danielcarton/Masters/README.md

Codebase for use in master's project spring 2024 by Daniel Carton and Tobias Lien.
