danielcarton/Masters/Energy_harvester_iot/Diagrams/Generated_temperature_trace.png

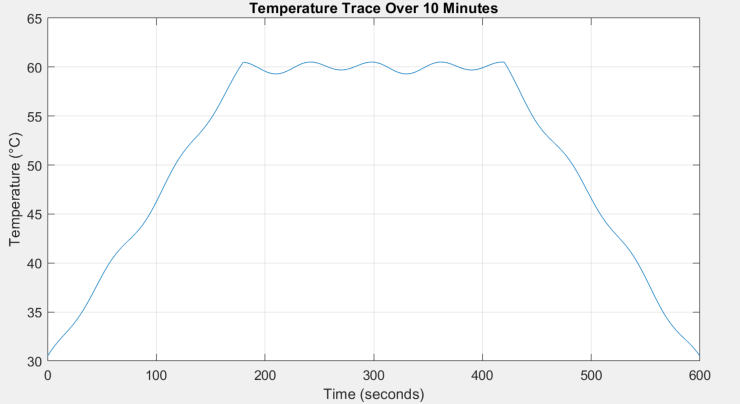
Energy_harvester_iot/Diagrams/Generated_temperature_trace.png
