danielcarton/Masters/Energy_harvester_iot/Diagrams/PID_temperature.png

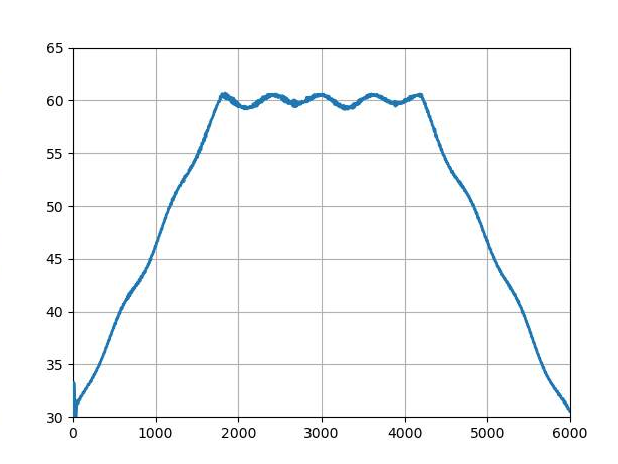
Energy_harvester_iot/Diagrams/PID_temperature.png
