danielcarton/Masters/Energy_harvester_iot/Diagrams/systemArchitecture - SoC.png

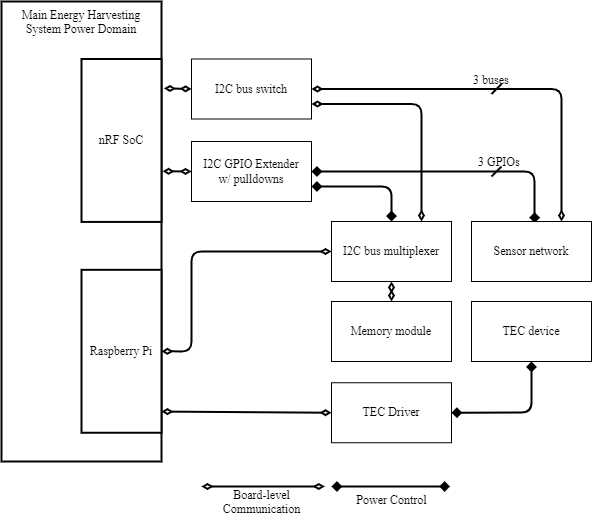
Energy_harvester_iot/Diagrams/systemArchitecture - SoC.png
