danielcarton/Masters/Energy_harvester_iot/Diagrams/EH-IoT_Eval_Board_Hardware_Architecture.pdf

## LED

## ADC 1

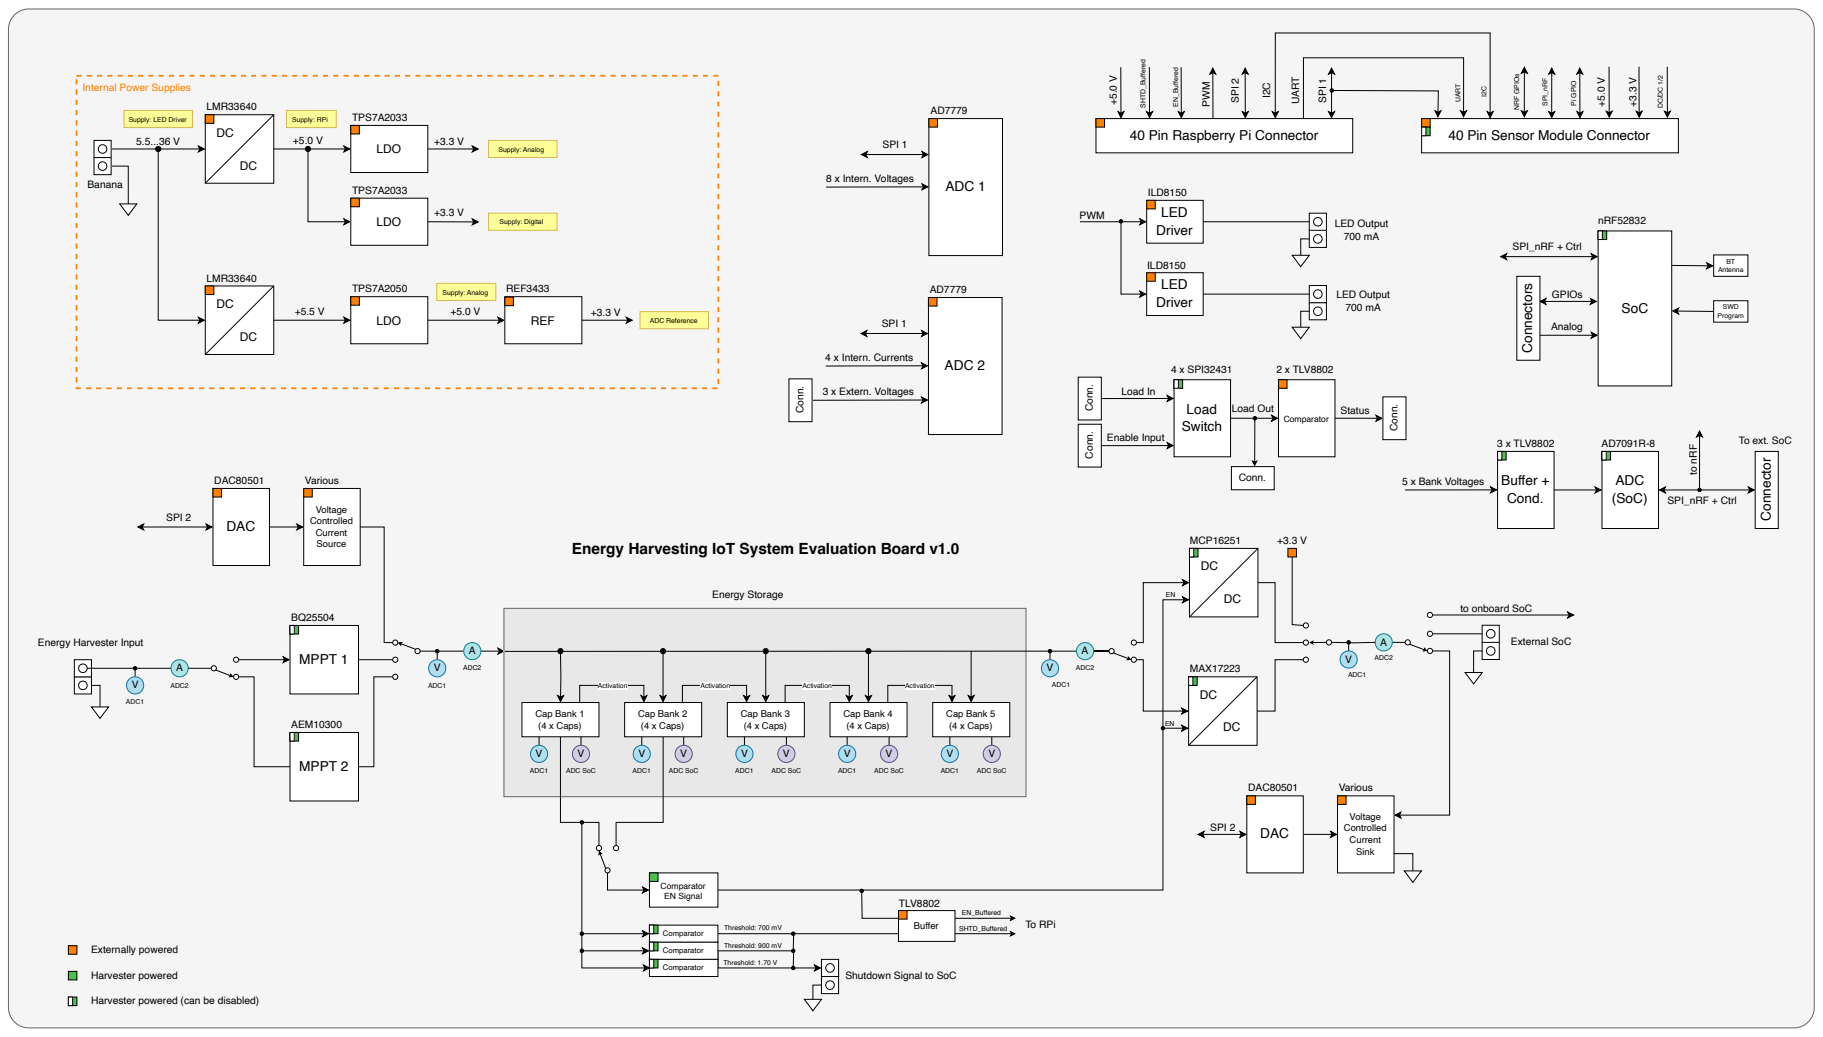
[picture p4: page 1]
LDO; TPS7A2033; LMR33640; REF; TPS7A2050; REF3433; MPPT 1; DAC; DAC80501; Voltage Controlled Current Source; Various; Activation; Cap Bank 1 (4 x Caps); Cap Bank 2 (4 x Caps); Cap Bank 3 (4 x Caps); Cap Bank 4 (4 x Caps); Cap Bank 5 (4 x Caps); ADC1; ADC2; Comparator EN Signal; Comparator; Threshold: 700 mV; Threshold: 900 mV; Threshold: 1.70 V; Voltage Controlled Current Sink; ADC (SoC); Buffer + Cond.; 3 x TLV8802; ADC SoC; 5 x Bank Voltages; Connector; Driver; PWM; SPI_nRF + Ctrl; SPI 2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

40 Pin Sensor Module Connector NRF GPIOs

Internal Power Supplies

Supply: LED Driver

40 Pin Raspberry Pi Connector

To ext. SoC

Energy Harvesting IoT System Evaluation Board v1.0

to onboard SoC

Shutdown Signal to SoC

Harvester powered (can be disabled)
