danielcarton/Masters/Energy_harvester_iot/Diagrams/Student_Project_EH-IOT_BlockDiagram.pdf

## Energy Harvesting IoT System Evaluation Board v1.0

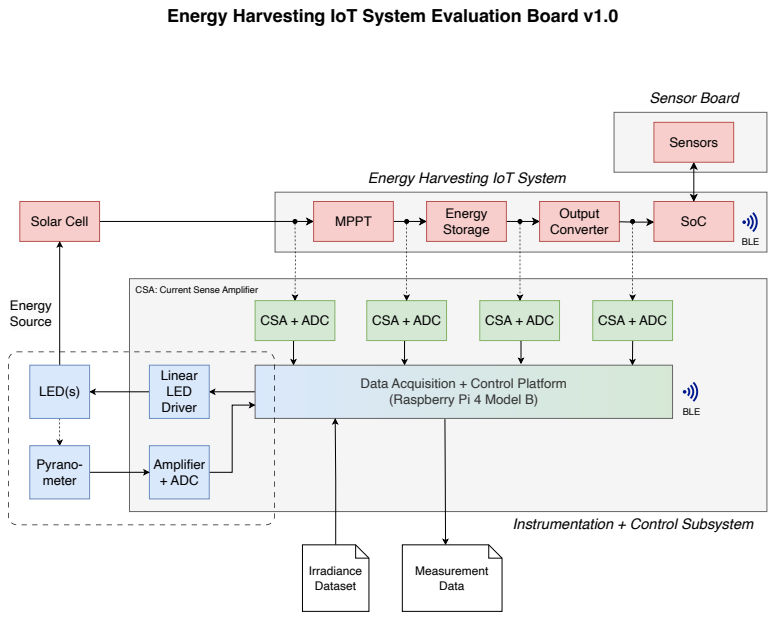
[picture p5: page 1]
Solar Cell; MPPT; Energy; Storage; Output Converter; CSA + ADC; Linear LED Driver; LED(s); Energy Source; Amplifier + ADC; Pyrano- meter; SoC; Sensors; Sensor Board; BLE; Irradiance Dataset; Measurement Data

Energy Harvesting IoT System

CSA: Current Sense Amplifier

Data Acquisition + Control Platform
(Raspberry Pi 4 Model B)

Instrumentation + Control Subsystem

## Energy Harvesting IoT System Evaluation Board v1.0

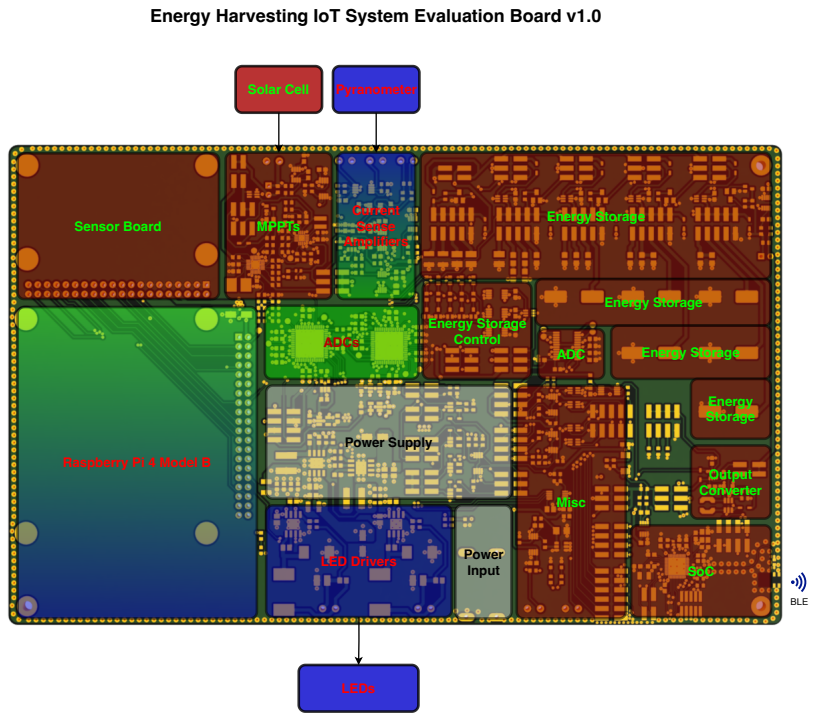
[picture p6: page 2]
MPPTs; Energy Storage; ADCs; LED Drivers; SoC; Sensor Board; Output Converter; Power Supply; Power Input; Solar Cell; LEDs; Current Sense Amplifiers; ADC; Misc; Energy Storage Control; Pyranometer; BLE

Raspberry Pi 4 Model B
