danielcarton/Masters/Energy_harvester_iot/Code/RaspberryPi/EH_IoT_Eval_240415/EH_IoT_Eval-master/modules/pinOut_BOARD.py

TP10            = 1
I2C_SDA         = 3
I2C_SCI         = 5
SHTD_BUF        = 7
UART_TXD        = 8
UART_RXD        = 10
SPI_2_CS_DAC2   = 11
SPI_2_CS_DAC1   = 12
ADC2_CONVST_SAR = 13
RPI_GPIO_22     = 15
ADC1_DRDY       = 16
ADC12_RESET     = 18
SPI_1_MOSI      = 19
SPI_1_MISO      = 21
ADC1_CONVST_SAR = 22
SPI_1_SCLK      = 23
SPI_1_CS_ADC1   = 24
SPI_1_CS_ADC2   = 26
CH1_READY       = 29
CH2_READY       = 31
LED_DRV_DIM     = 32
CH3_READY       = 33
CH4_READY       = 35
SPI_1_CS_3      = 36
DCDC_EN_BUF     = 37
SPI_2_MOSI      = 38
SPI_2_SCLK      = 40
