danielcarton/Masters/Energy_harvester_iot/Code/SoC/src/I2C_control.c

// #include "I2C_control.h"
// #include <zephyr/drivers/i2c.h>

// #define I2C0_GPIO_EXTENDER DT_NODELABEL(GPIO_extender)
// #define I2C0_I2C_SWITCH DT_NODELABEL(I2C_switch)
// #define I2C0_TEMP1 DT_NODELABEL(temp1)
// #define I2C0_TEMP2 DT_NODELABEL(temp2)
// #define I2C0_TEMP3 DT_NODELABEL(temp3)
// #define I2C0_TEMP4 DT_NODELABEL(temp4)
// #define I2C0_TEMP5 DT_NODELABEL(temp5) 
// #define I2C0_TEMP6 DT_NODELABEL(temp6)

// static const struct i2c_dt_spec dev_i2c = I2C_DT_SPEC_GET(I2C0_TEMP6);


// // Initialize I2C
// void i2c_init(void){

// }

// // Write data to I2C
// void i2c_write(uint8_t addr, uint8_t *data, uint8_t len){

// }

// // Read data from I2C
// void i2c_read(uint8_t addr, uint8_t *data, uint8_t len){

// }
