danielcarton/Masters/Energy_harvester_iot/Code/SoC/src/I2C_Switch.h

#ifndef _I2C_SWTICH_H_
#define _I2C_SWTICH_H_

#include "macros.h"
#include "I2C.h"

#define I2C_SWITCH_BASE_ADDR 0xEE

void I2C_switch_setChannel(uint8_t mask);

uint8_t I2C_switch_readChannels(void);


#endif // !_I2C_SWTICH_H_
