danielcarton/Masters/Energy_harvester_iot/Code/SoC/src/inc.h

#ifndef _INC_H_
#define _INC_H_

#include "accuracyAlgorithms.h"
#include "GPIO_extender.h"
#include "I2C_Switch.h"
#include "I2C.h"
// #include "macros.h"
#include "memory.h"
#include "TempSensor.h"
#include "timers.h"

#include <core_cm4.h>

#endif // !_INC_H
