danielcarton/Masters/Energy_harvester_iot/Code/Test/Arduino_I2C_Scanner/I2C.h

#ifndef _I2C_CONTROL_H_
#define _I2C_CONTROL_H_

#include "macros.h"


#define TWIM_SDA_PIN 20
#define TWIM_SCL_PIN 19

#define TWIM_INST_IDX 0

// Initialize I2C
void i2c_init(void);

// Write data to I2C
void i2c_write(u8 addr, u8 *data, u8 len);

// Read data from I2C
void i2c_read(u8 addr, u8 *data, u8 len);


#endif // !_I2C_CONTROL_H_
