danielcarton/Masters/(commit log)

2024-05-16 Temperature trace generator
2024-05-18 Diagrams and shiiii
    [reference_1_results.csv, reference_2_results.csv, reference_3_results.csv, reference_4_results.csv, reference_results.csv, temperature_trace.csv]
2024-05-28 Big update
    [arch_trace.csv, arch_trace_reference_results.csv, constant_trace.csv, constant_trace_reference_results.csv, plateau_trace.csv, plateau_trace_reference_results.csv, sine_trace.csv, sine_trace_reference_results.csv]
2024-05-28 File restructure
    [arch_trace.csv, arch_trace_reference_results.csv, constant_trace.csv, constant_trace_reference_results.csv, plateau_trace.csv, plateau_trace_reference_results.csv, sine_trace.csv, sine_trace_reference_results.csv]
